pieglnMSOE/Beaglebone-CAN-Cape/beaglebone_can_cape.kicad_pcb

## KiCad design beaglebone_can_cape.kicad_pcb (2026-02-22)

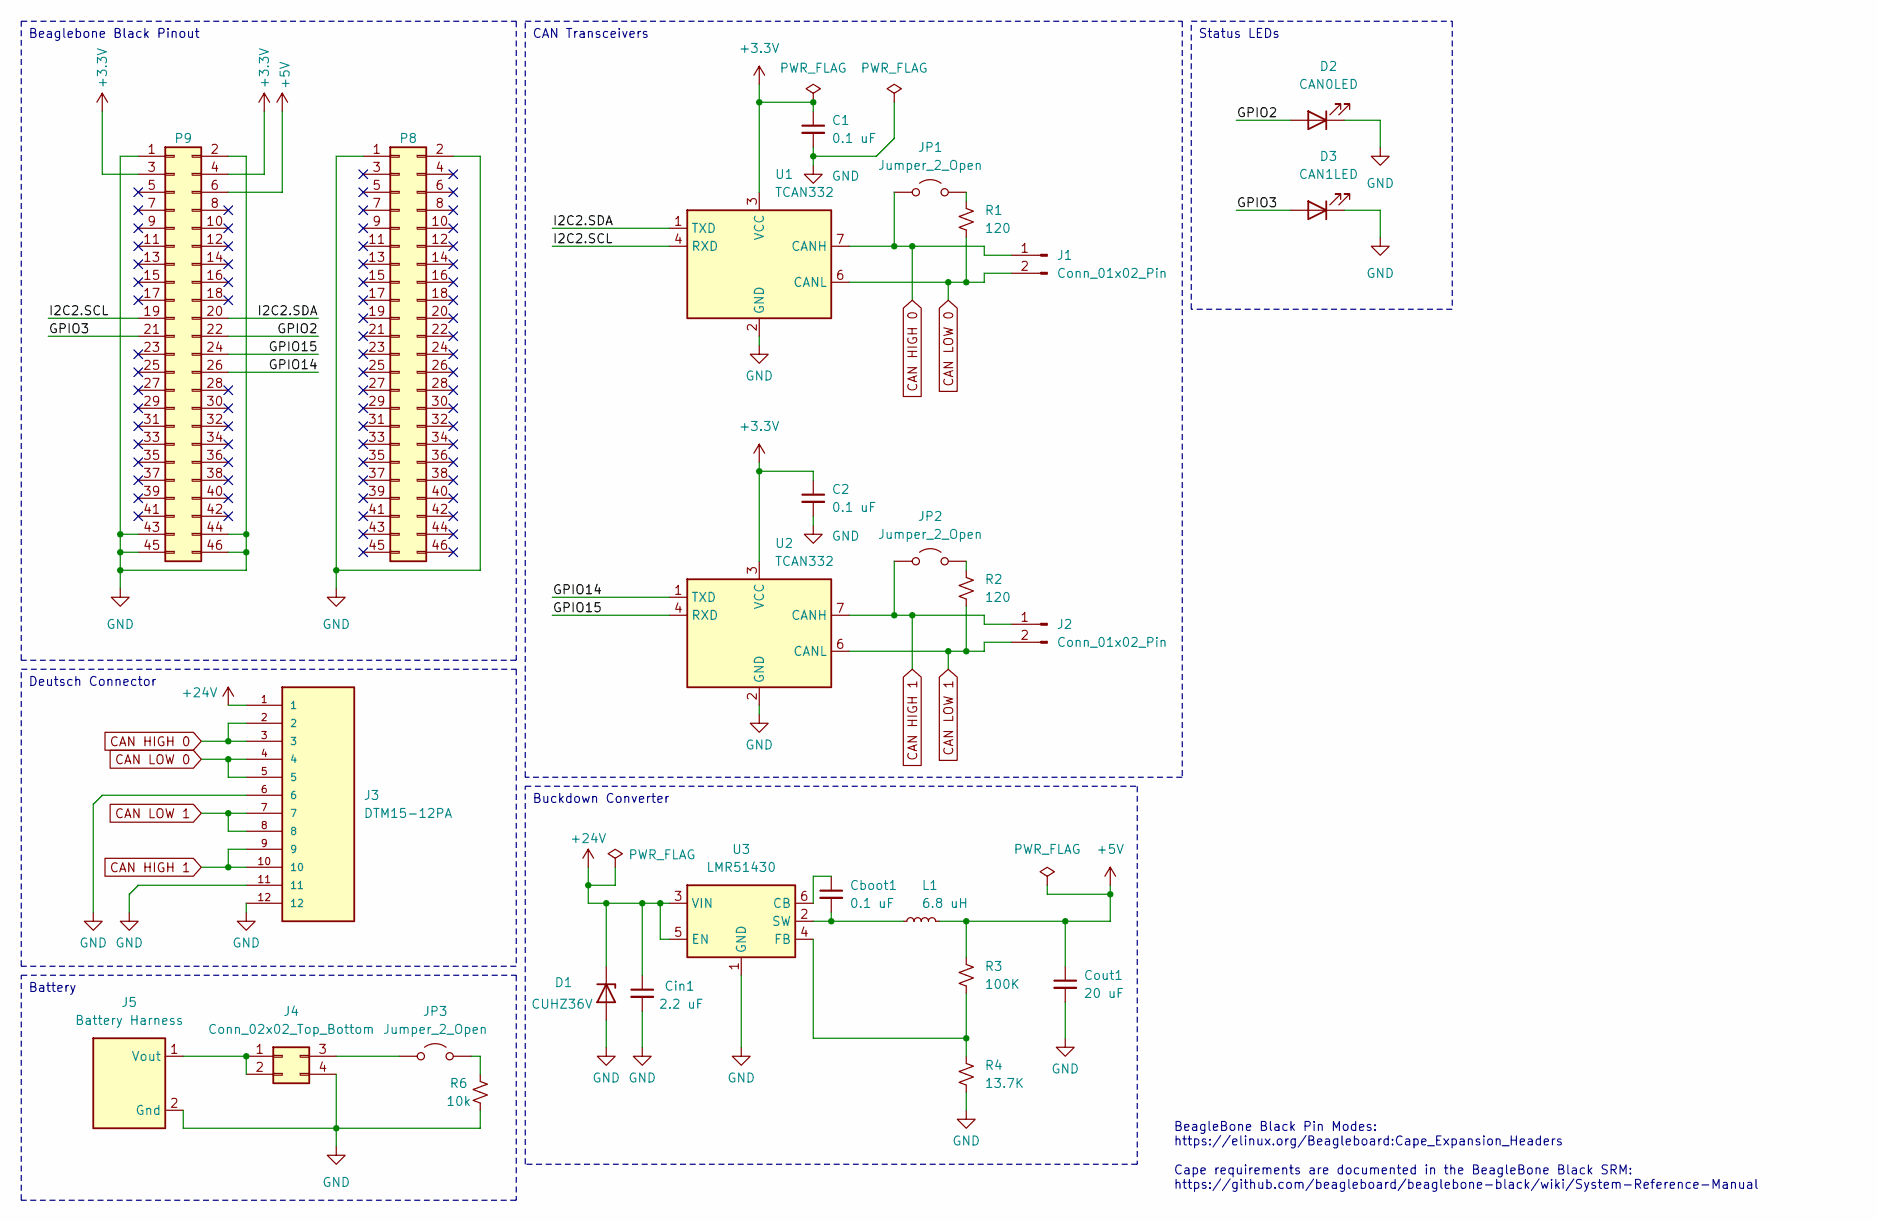
[picture p1: schematic beaglebone_can_cape.kicad_sch]

Parts:
C1, C2: 0.1 uF; C_0805_2012Metric
Cboot1: 0.1 uF; C_0805_2012Metric
Cin1: 2.2 uF; CP_Elec_6.3x5.4
Cout1: 20 uF; CP_Elec_6.3x5.4
D1: CUHZ36V; TVSDiode
D2: CAN0LED; LED_0805_2012Metric
D3: CAN1LED; LED_0805_2012Metric
J1, J2: Conn_01x02_Pin; PinHeader_1x02_P2.54mm_Vertical
J3: DTM15-12PA; Deutsch_Marlin; MPN DTM15-12PA
J4: Conn_02x02_Top_Bottom; PinHeader_2x02_P2.54mm_Vertical
J5: Battery Harness; BatteryHolder
JP1, JP2, JP3: Jumper_2_Open; PinHeader_1x02_P2.54mm_Vertical
L1: 6.8 uH; HPC6045NV
P8, P9: BeagleBone_Black_Header; PinHeader_2x23_P2.54mm_Vertical
R1, R2: 120; R_0805_2012Metric
R3: 100K; R_0805_2012Metric
R4: 13.7K; R_0805_2012Metric
R6: 10k; R_0805_2012Metric
U1, U2: TCAN332; D0008A_M
U3: LMR51430; SOT-23-6

Connections:
+3.3V: C1.1, C2.1, P9.3, P9.4, U1.3 (VCC), U2.3 (VCC)
+5V: Cout1.1, L1.2, P9.6, R3.1
+24V: Cin1.1, D1.1 (K), J3.1, U3.3 (VIN), U3.5 (EN)
/GPIO2: D2.2 (A), P9.22
/GPIO3: D3.2 (A), P9.21
/GPIO14: P9.26, U2.1 (TXD)
/GPIO15: P9.24, U2.4 (RXD)
/I2C2.SCL: P9.19, U1.4 (RXD)
/I2C2.SDA: P9.20, U1.1 (TXD)
CAN HIGH 0: J1.1, J3.2, J3.3, JP1.1 (A), U1.7 (CANH)
CAN HIGH 1: J2.1, J3.9, J3.10, JP2.1 (A), U2.7 (CANH)
CAN LOW 0: J1.2, J3.4, J3.5, R1.2, U1.6 (CANL)
CAN LOW 1: J2.2, J3.7, J3.8, R2.2, U2.6 (CANL)
GND: C1.2, C2.2, Cin1.2, Cout1.2, D1.2 (A), D2.1 (K), D3.1 (K), J3.6, J3.11, J3.12, J4.4, J5.2 (Gnd), P8.1, P8.2, P9.1, P9.2, P9.43, P9.44, P9.45, P9.46, R4.2, R6.2, U1.2 (GND), U2.2 (GND), U3.1 (GND)
unnamed: J4.1, J4.2, J5.1 (Vout)
unnamed: J4.3, JP3.1 (A)
unnamed: JP1.2 (B), R1.1
unnamed: JP2.2 (B), R2.1
unnamed: JP3.2 (B), R6.1
unnamed: Cboot1.1, U3.6 (CB)
unnamed: R3.2, R4.1, U3.4 (FB)
unnamed: Cboot1.2, L1.1, U3.2 (SW)

Notes on the sheet:
BeagleBone Black Pin Modes: https://elinux.org/Beagleboard:Cape_Expansion_Headers Cape requirements are documented in the BeagleBone Black SRM: https://github.com/beagleboard/beaglebone-black/wiki/System-Reference-Manual
Deutsch Connector
Beaglebone Black Pinout
Buckdown Converter
Battery
CAN Transceivers
Status LEDs

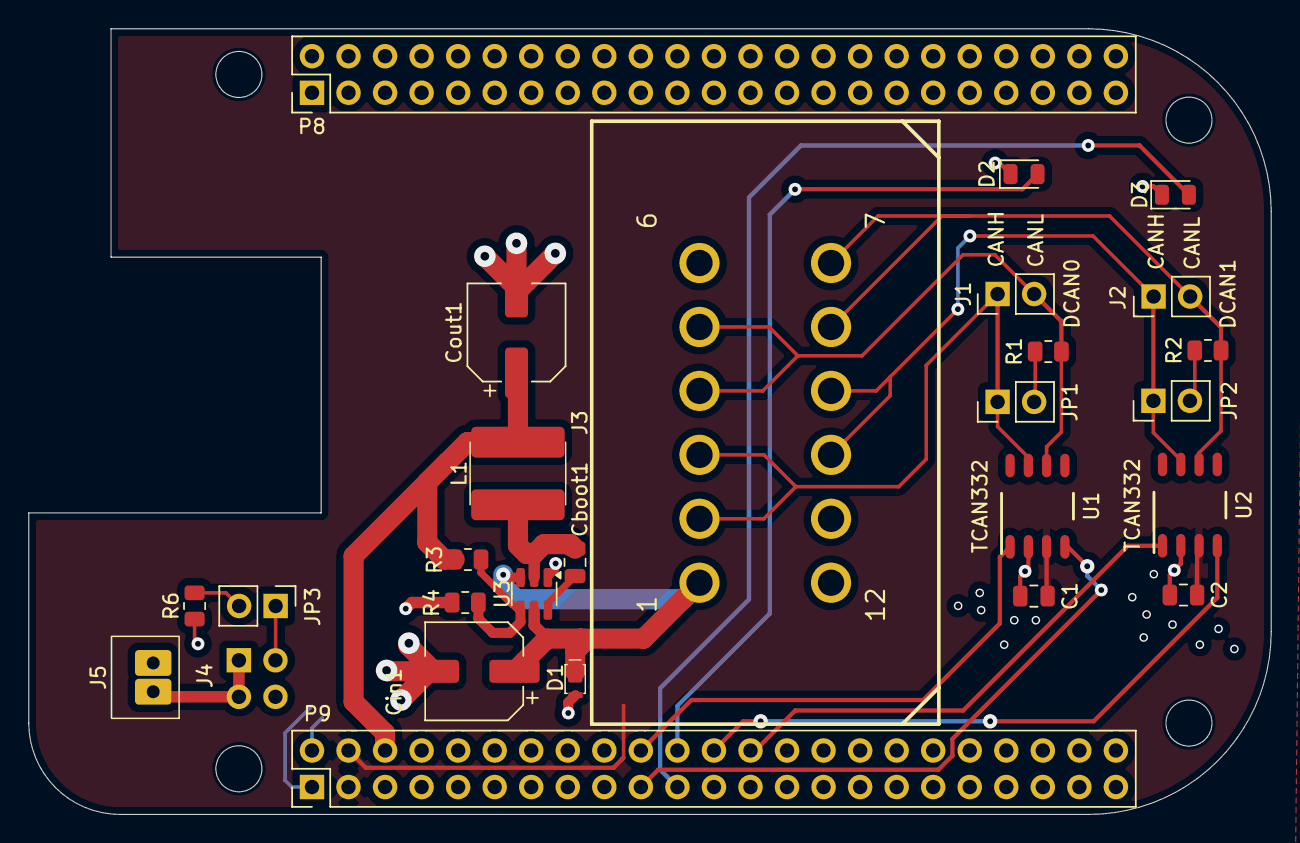
[picture p2: board beaglebone_can_cape.kicad_pcb from above]

Board: 2 copper layers, 86.4 x 54.6 mm, 31 parts (1 on the bottom side), 22 nets.

Other parts of the board:
MH1, MH2, MH3, MH4: MountingHole_3.2mm_M3_DIN965
