pieglnMSOE/Beaglebone-CAN-Cape/(commit log)

2026-01-24 Attempting edits in schematic to push
    [beaglebone_can_cape.kicad_sch]
2026-01-25 Working on schematic file
    added can devices and pinout, needs footprints
    [beaglebone_can_cape.kicad_sch]
2026-02-01 Updating to Zach's
    It works!
    [beaglebone_can_cape.kicad_sch]
2026-02-01 Create .gitignore
    KiCad template awesome
2026-02-02 Finished with schematic
    Did research on TCAN332 vs SN65HVD230, trying TCAN332 first. All footprints loaded.
    [beaglebone_can_cape.kicad_pcb, beaglebone_can_cape.kicad_sch]
2026-02-02 Laid out CAN on PCB
    'Nuff said
    [beaglebone_can_cape.kicad_pcb, beaglebone_can_cape.kicad_sch]
2026-02-02 Tweaks to footprints
    Moved around pcb silkscreens for readability, think it looks better
    [beaglebone_can_cape.kicad_pcb]
2026-02-03 PCB and SCH updates
    Just moved some text boxes, footprints, and explored ideas for the Deutsch connectors.
    [beaglebone_can_cape.kicad_pcb, beaglebone_can_cape.kicad_sch]
2026-02-04 Pushing pcb additions of buckdown, need more work on schem
    [beaglebone_can_cape.kicad_pcb, beaglebone_can_cape.kicad_sch]
2026-02-04 Removed temp gnd plane b.cu
    nuff said
    [beaglebone_can_cape.kicad_pcb]
2026-02-05 Symbol may not be needed, we will see...
    [beaglebone_can_cape.kicad_pcb, beaglebone_can_cape.kicad_sch]
2026-02-07 Pushing changes, added deutsch connector and some global variables
2026-02-07 pushing schem from added deutsch
    [beaglebone_can_cape.kicad_sch]
2026-02-08 Schematic + PCB support of Deutsch
    * Imported the DTM15-12PA footprint (this one is not correct as Marlin has a smaller footprint I know now)
    * Removed "PWR" label and replaced with 5V net
    * Reviewed the new schematic fooprint that Zach added, looks good
    [beaglebone_can_cape.kicad_pcb, beaglebone_can_cape.kicad_sch]
2026-02-11 taking break, letting Nash cook
    [beaglebone_can_cape.kicad_pcb, beaglebone_can_cape.kicad_sch]
2026-02-11 PCB Version 1: Before Week 4 Meeting
    * Reorganized the board to support Deutsch
    * Assigned all components to have footprints
    * Simplified the schematic, namely the pins
    * Created the battery circuit and put on PCB
    [beaglebone_can_cape.kicad_pcb, beaglebone_can_cape.kicad_sch]
2026-02-15 did I forget to push this before? oops
    [beaglebone_can_cape.kicad_sch]
2026-02-16 pushing added TVS diode in schem, not wired in yet, working on footprint now
    [beaglebone_can_cape.kicad_sch]
2026-02-16 pushing footprint assignment on schem
    [beaglebone_can_cape.kicad_sch]
2026-02-16 added tvs diode to schem
    [beaglebone_can_cape.kicad_sch]
2026-02-16 pushing for nash work
    [beaglebone_can_cape.kicad_pcb, beaglebone_can_cape.kicad_sch]
2026-02-17 Implementing Deutsch + wiring
    * Got rid of more errors and corrected more footprints. Going smoothly.
    * Researched the TVS diode. cool stuff!
    [beaglebone_can_cape.kicad_pcb, beaglebone_can_cape.kicad_sch]
2026-02-17 PCB updates
    Wiring and moving TVS and Deutsch
    [beaglebone_can_cape.kicad_pcb]
2026-02-17 pushing pwr_flag and ERC changes
    [beaglebone_can_cape.kicad_pcb, beaglebone_can_cape.kicad_sch]
2026-02-18 Before-Meeting final PCB and Schematic changes
    * Redid the battery circuit to be... yk... correct because I wired it wrong the first time lols
    * I changed the width of all high voltage & current lines to 0.8mm, really no big change there, nothing had to be moved
    * Looked in depth at anything missing, I think we're just about good to go
    [beaglebone_can_cape.kicad_pcb, beaglebone_can_cape.kicad_sch]
2026-02-18 Joey request LED + battery harness things
    [beaglebone_can_cape.kicad_pcb, beaglebone_can_cape.kicad_sch]
2026-02-18 pushing changes
    [beaglebone_can_cape.kicad_pcb, beaglebone_can_cape.kicad_sch]
2026-02-18 cleaning up
    [beaglebone_can_cape.kicad_sch]
2026-02-18 Touch-ups for PCB + Schematic
    * Made more presentable for tomorrow's advisor meeting
    [beaglebone_can_cape.kicad_pcb, beaglebone_can_cape.kicad_sch]
2026-02-18 Cleaned up silkscreen layer
    * Made all descriptors have the same rotation for cleanliness
    * Small bonus, also heavily simplified the battery harness circuit
    [beaglebone_can_cape.kicad_pcb]
2026-02-20 pushing changes complying with 9.4
    [beaglebone_can_cape.kicad_pcb]
2026-02-20 pushing one more change
    [beaglebone_can_cape.kicad_pcb]
2026-02-20 one more change lol
    [beaglebone_can_cape.kicad_pcb]
2026-02-20 Revert "one more change lol"
    This reverts commit 632872a148e7318c24db7e3d55eca11b182aeb42.
    [beaglebone_can_cape.kicad_pcb]
2026-02-20 Revert "pushing one more change"
    This reverts commit ff178eb84cf028675ee4f732a8757c322aa0ec1f.
    [beaglebone_can_cape.kicad_pcb]
2026-02-20 Revert "pushing changes complying with 9.4"
    This reverts commit c8ddab446e25520ae04b9c74253210672d119c98.
    [beaglebone_can_cape.kicad_pcb]
2026-02-20 updated main with 9.4 changes, with battery stuff etc.
    [beaglebone_can_cape.kicad_pcb]
2026-02-20 9.4 Changes
    * Checked on the LMR51430 circuit and made R4 + R5 parallel rather than series
    * Electrolytic capacitors needed for Cin and Cout
    * Rewiring of buck down necessary to fit big boy Caps
    [beaglebone_can_cape.kicad_pcb]
2026-02-20 pushing changes with big caps
    [beaglebone_can_cape.kicad_pcb, beaglebone_can_cape.kicad_sch]
2026-02-20 pushing drc constraint changes
    [beaglebone_can_cape.kicad_pcb]
2026-02-21 Beefier TMR Circuit
    * Beefed up the capacitors for the TMR circuit with Zach (earlier today)
    * Begun looking into a beefer inductor (3A min rating w a 5A min SAT current rating) (6060 metrics look good)
    * Added copper floods for thermal relief from inductor to cap and resistor (Vout of TMR)
    * More vias!
    [beaglebone_can_cape.kicad_pcb]
2026-02-22 Added new inductor (HPC6045NV) to PCB
    * Finalized PCB with the new inductor gggggggg
    [beaglebone_can_cape.kicad_pcb, beaglebone_can_cape.kicad_sch]
2026-02-22 pushing gerbers :D
    [beaglebone_can_cape-B_Cu.gbr, beaglebone_can_cape-B_Mask.gbr, beaglebone_can_cape-B_Silkscreen.gbr, beaglebone_can_cape-Edge_Cuts.gbr, beaglebone_can_cape-F_Cu.gbr, beaglebone_can_cape-F_Mask.gbr, beaglebone_can_cape-F_Paste.gbr, beaglebone_can_cape-F_Silkscreen.gbr]
